fr0der1c/env2metric/design/yn038_esp32s3_case/README.md

# YN038 ESP32-S3 PLA 卡扣外壳（V2）

该外壳按已测量的 YN038 开发板制作：PCB 为 63.00 × 27.92 × 1.61 mm；ESP32 模组天线端超出主 PCB 6.81 mm；背面排针突出 8.58 mm；PCB 底面到 USB-C 最高点为 4.88 mm。

设计特点：

- 同侧双 USB-C 使用两个 9.40 × 3.80 mm、两端全圆角的独立贯通孔；两孔中心距 10.47 mm，中间保留 1.07 mm 实体筋，孔顶保留 1.80 mm PLA 横梁；
- 背面每个排针各有一个内部盲槽；壳内底部留 0.70 mm 安全余量，针尖不会露出；
- 44 个盲槽位于两条 5.50 mm 高的实体导轨中，导轨顶部避开排针塑胶座；
- 顶盖完全封闭；BOOT、RESET 和所有指示灯均不设贯通开口；
- G3 上方为 5.20 × 5.20 mm、厚 0.80 mm 的半透明薄窗，中心距 PCB 短边左侧 8.10 mm、距 USB 端 30.67 mm；沿板长定位依据为天线侧主 PCB 边到灯珠左沿 29.83 mm；
- G3 薄窗内侧带 2.00 mm 深的方形光井，减少侧视视差和其他灯光串入；
- PWR/TX/RX 区域内侧局部总厚度为 3.10 mm，并带 2.20 mm 深的四周遮光围墙；
- 需要手动操作 BOOT/RESET 时拆下卡扣顶盖；
- 顶盖在 ESP32 模组/天线区域保持封闭；常规负载依靠壳内空间和现有接口开口被动散热；
- 后端内腔覆盖 ESP32 模组伸出主 PCB 的 6.81 mm 天线段，并保留 0.40 mm 间隙；
- 四个 PLA 友好型宽卡扣，钩头带 0.45 mm 导入斜坡，卡舌通过局部根座贯穿整个顶板厚度；
- 卡扣位于底壳外侧，不占用 PCB 两侧装配间隙。

## 自动检查

- `part = "collision"` 会用整板最高元件包络、PCB 和 44 根针脚检查底壳/顶盖干涉；正确结果为空几何；
- `review.png` 是直接读取最终 STL 面片生成的六视图，不是 OpenSCAD 源码预览；
- 最终 STL 必须同时满足单一连通体、每条网格边恰好被两个三角面共享。

## 导出

在 OpenSCAD 打开 `yn038_esp32s3_case.scad`：

1. 将 `part` 设为 `"base"`，F6 渲染，导出 `yn038_esp32s3_base.stl`。
2. 将 `part` 设为 `"lid"`，F6 渲染，导出 `yn038_esp32s3_lid.stl`。

## 打印

- 材料：烟灰、自然色或磨砂半透明 PLA（烟灰色对 PWR 红光抑制最好）
- 层高：0.20 mm
- 壁数：3
- 填充：15%
- 支撑：关闭
- 底壳：底面朝下；顶盖：STL 已翻转，外表面朝下、卡扣朝上。

半透明顶盖建议使用光面打印板获得更清晰的内部轮廓；纹理 PEI 会产生更均匀的磨砂扩散效果。G3 薄窗为 0.80 mm，使用 0.20 mm 层高时正好四层。

首次装配先只压入一侧卡扣，确认 USB-C 无干涉，再逐个压入其余卡扣。若外壳偏紧，可把 `clearance_xy` 从 `0.40` 调为 `0.55` 后重新导出。

## 许可证

本目录的原创 SCAD 源文件、STL 模型、预览图片和文档采用 [CC BY-NC-SA 4.0](../../LICENSES/CC-BY-NC-SA-4.0.txt)，作者署名为 [frederic (@fr0der1c)](https://github.com/fr0der1c)，项目来源为 [env2metric](https://github.com/fr0der1c/env2metric)。

允许在许可证范围内为非商业目的复制、修改和分享。分享时须保留署名、项目来源和许可证链接，并说明修改；分享改编版本时须遵守相同方式共享条款。该许可不授权将这些设计用于商业目的。完整许可范围见 [LICENSE](../../LICENSE)。
