fr0der1c/env2metric/design/yn038_esp32s3_case/review.png

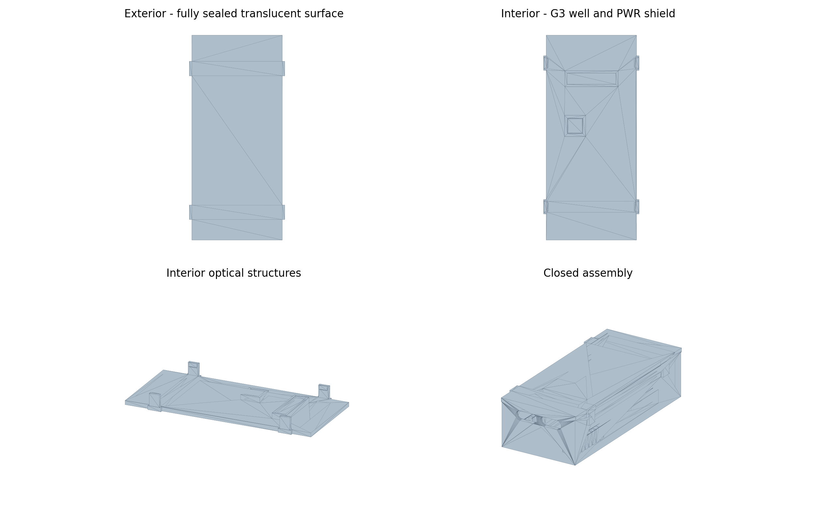
design/yn038_esp32s3_case/review.png
