fr0der1c/env2metric/design/yn038_esp32s3_case/yn038_esp32s3_base.stl

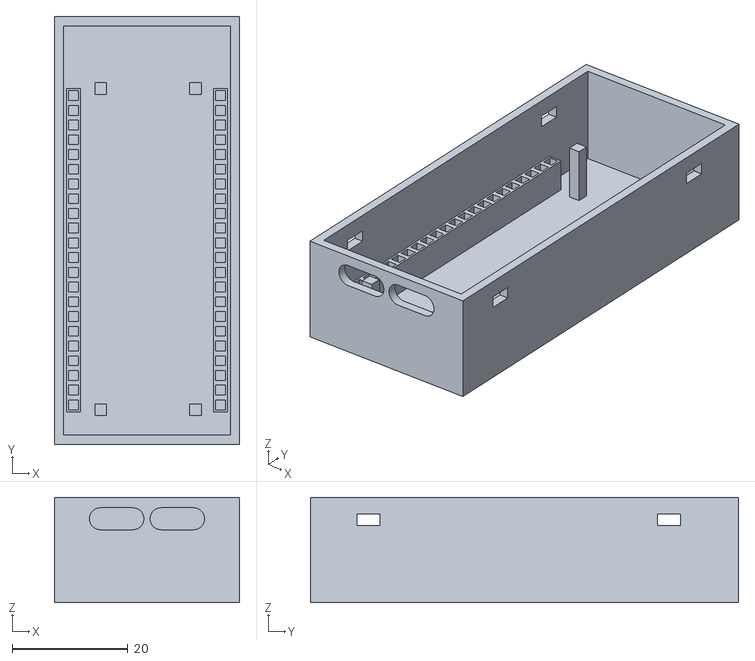
[picture p2: CAD file, 2026-08-01]
design/yn038_esp32s3_case/yn038_esp32s3_base.stl
31.9 x 73.8 x 18.2
