fr0der1c/env2metric/design/yn038_esp32s3_case/yn038_esp32s3_lid.stl

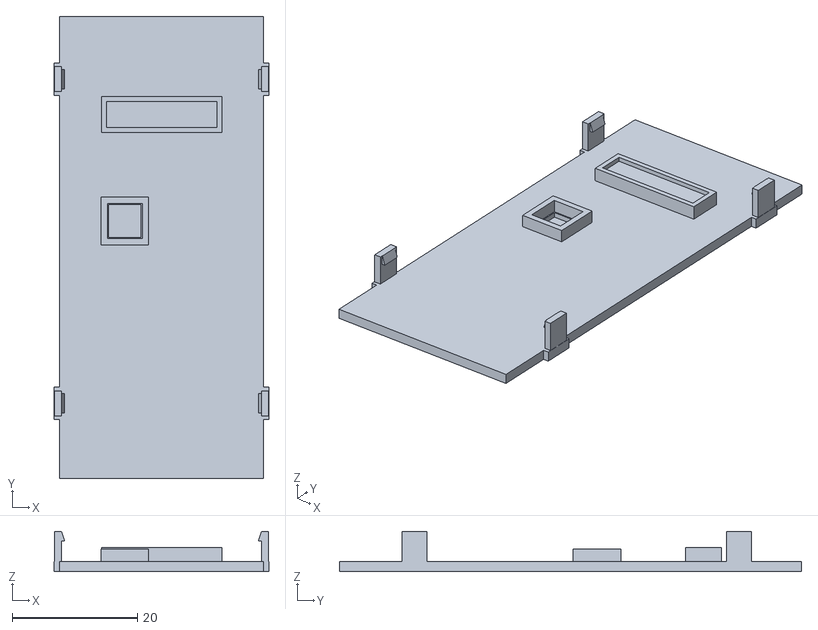
[picture p3: CAD file, 2026-08-01]
design/yn038_esp32s3_case/yn038_esp32s3_lid.stl
34.3 x 73.8 x 6.40
