fr0der1c/env2metric/(commit log)

2026-08-01 feat: 完善空气质量看板与外壳设计
    [yn038_esp32s3_base.stl, yn038_esp32s3_case.scad, yn038_esp32s3_lid.stl]
2026-10-15 fix: 修复 USB 重连后的采集状态残留
    [air_quality_validator.cpp, air_quality_validator.hpp]
2026-10-15 docs: 添加非商业许可证并更新 README 说明
2026-10-15 ci: 添加固件构建检查并迁移至官方组件管理器
2026-10-15 fix: 使用内容校验检查 CI 依赖锁文件
2026-10-15 docs: 说明可观测平台兼容性并修正 USB 线材信息
2026-10-15 docs: 完善作者署名并修正白灯时序说明
2026-10-20 feat: 每周通过 USB 自动重启空气质量检测仪
